Quarren42/SPIN/KiCad_Design_Files/Spin v1.4 top board/TestProject.png

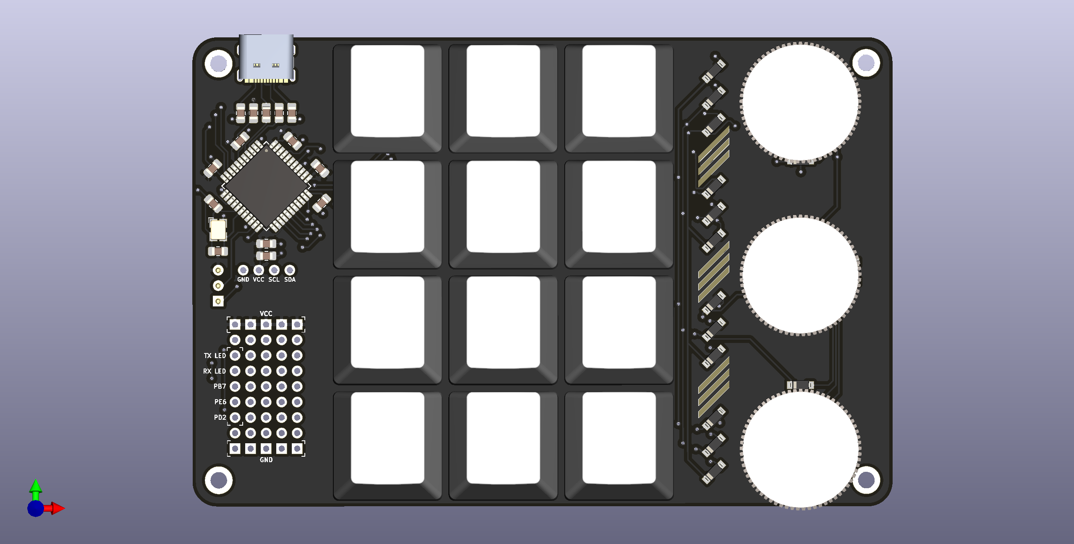
KiCad_Design_Files/Spin v1.4 top board/TestProject.png
