Quarren42/SPIN/README.md

# SPIN

SPIN

An open source 12 key, 3 encoder, hotswappable USB-C Macro Pad powered by [QMK Firmware](https://github.com/qmk/qmk_firmware)

You can purchase one at [DMQ Design](http://dmqdesign.com/), or follow the files here and build your own from scratch!
