Quarren42/SPIN/BOM/MacroPad_BOM_Assembly.xlsx

Ref. Designator | Manufacturer Part Number | Qty | Description | Package
J1 | USB4105-GF-A | 1 | USB-C USB 2.0 Receptacle Connector 24 (16 + 8 dummy) position SMD
C3, C4, C5, C6 | CL21B104KACNNNC | 4 | Ceramic Cap, 0805, 0.1uF | 0805
R3, R4 | RC0805JR-0722RL | 2 | Resistor, 0805, 22Ω | 0805
R1, R2 | RNCP0805FTD10K0 | 2 | Resistor, 0805, 10kΩ | 0805
C1, C2 | C0805C220J5GACTU | 2 | Ceramic Cap, 0805, 22pF | 0805
X1 | FA-238 16.0000MB-K3 | 1 | CRYSTAL 16.00 MHZ 10PF SMD | 4-SMD, No Lead
U1 | ATMEGA32U4-AU | 1 | IC MCU 8BIT 32KB FLASH 44TQFP | 44-TQFP
SW1 | EVQ-P7C01P | 1 | SWITCH TACTILE SPST-NO 0.05A 12V
D1, D2, D3, D4, D5, D6, D7, D8, D9, D10, D11, D12, D13, D14, D15 | 1N4148W-HE3-08 | 15 | DIODE GEN PURP 75V 150MA SOD123 | SOD123
C7 | CL21F475ZPFNNNE | 1 | Ceramic Cap, 0805, 4.7uF | 0805
C8 | CC0805ZRY5V8BB105 | 1 | Ceramic cap, 0805, 1uF | 0805
R5, R6 | CRG0805F1K5 | 2 | Resistor, 0805, 1.5kΩ | 0805
D101, D102, D103 | WS2812B | 3 | WS2812B RGB LED | PLCC4
R101 | CRGCQ0805F330R | 1 | Resistor, 0805, 330Ω | 0805
