Quarren42/SPIN/Production Files/Spin_v1.4_newReset/MacroPad_BOM_Assembly_NEW_JLC.xlsx

Comment | Designator | Footprint | JLCPCB Part #
USB-C USB 2.0 Receptacle Connector 24 (16 + 8 dummy) position SMD | J1 |  | C720629
Ceramic Cap, 0805, 0.1uF | C3, C4, C5, C6 | 0805 | C49678
Resistor, 0805, 22Ω | R3, R4 | 0805 | C17561
Resistor, 0805, 10kΩ | R1, R2 | 0805 | C17414
Ceramic Cap, 0805, 22pF | C1, C2 | 0805 | C1804
FA-328 16.0MB-K3 CRYSTAL 16.00 MHZ 10PF SMD | X1 | 4-SMD, No Lead
ATMEGA32U4-AU | U1 | 44-TQFP
DIODE GEN PURP 75V 150MA SOD123 | D1, D2, D3, D4, D5, D6, D7, D8, D9, D10, D11, D12, D13, D14, D15 | SOD123 | C169542
Ceramic Cap, 0805, 4.7uF | C7 | 0805 | C1779
Ceramic cap, 0805, 1uF | C8 | 0805 | C28323
Resistor, 0805, 5.1kΩ | R5, R6 | 0805 | C27834
WS2812B RGB LED | D101, D102, D103 | PLCC4 | C2761795
Resistor, 0805, 330Ω | R101 | 0805 | C17630
