Quarren42/SPIN/CAD_Files/AcrylicCover.dxf

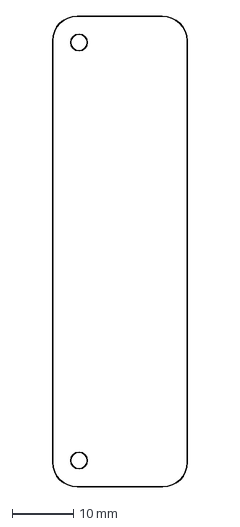
[picture p3: CAD file, 2020-04-21]
CAD_Files/AcrylicCover.dxf
22.0 x 77.0 mm
