Quarren42/SPIN/KiCad_Design_Files/Spin v1.4 bottom board/TestProject.step

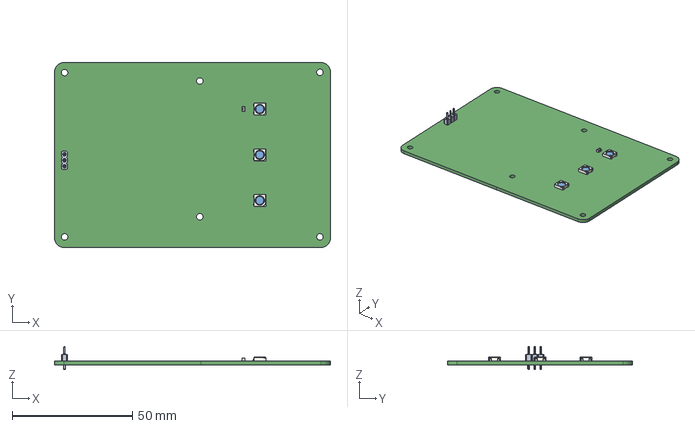
[picture p4: CAD file, 2020-04-21]
KiCad_Design_Files/Spin v1.4 bottom board/TestProject.step
114.9 x 77.0 x 9.78 mm
