Quarren42/SPIN/KiCad_Design_Files/Spin v1.4 top board/TestProject.kicad_pcb

## KiCad design KiCad_Design_Files/Spin v1.4 top board/TestProject.kicad_pcb (2020-04-21)

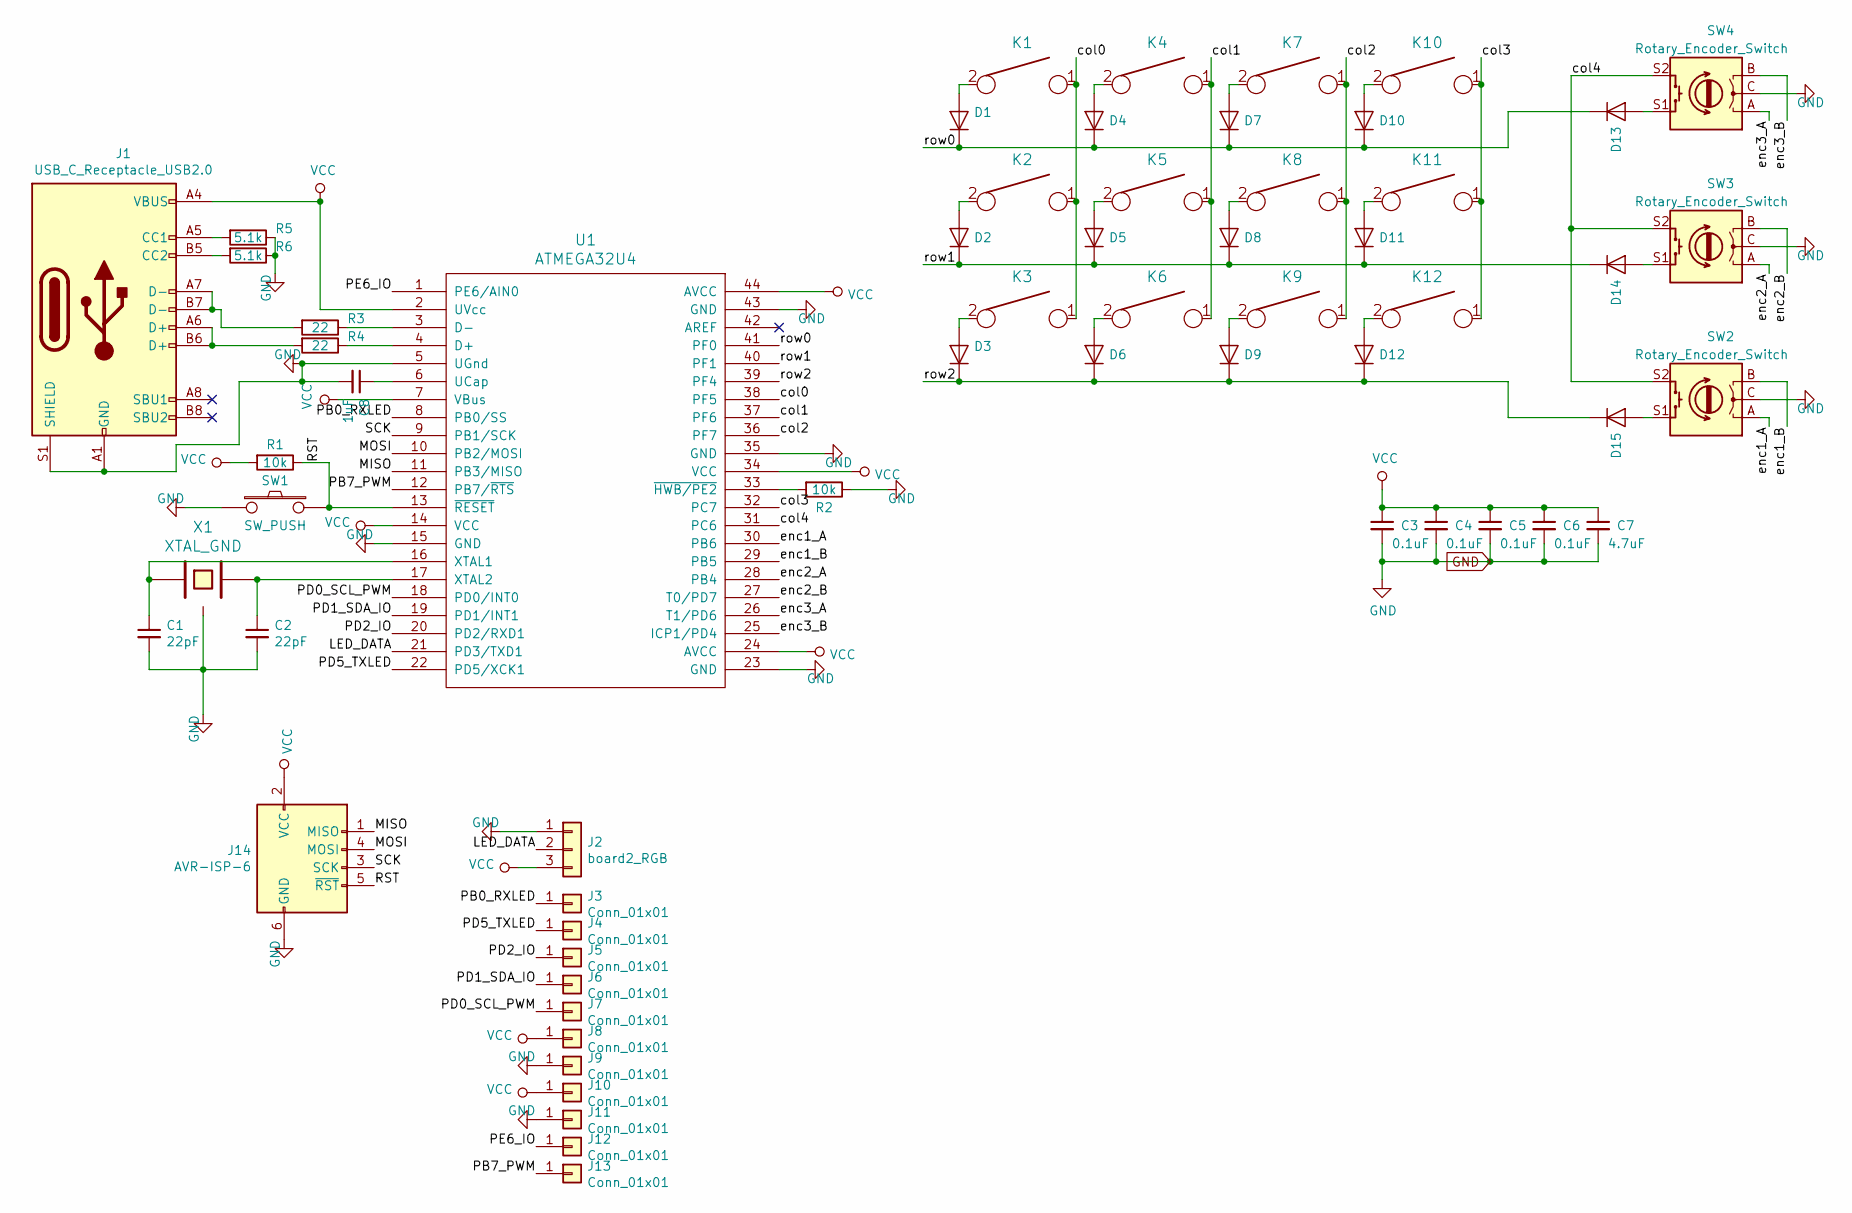
[picture p5: schematic TestProject.sch]

Parts:
C1, C2: 22pF; C_0805_2012Metric_Pad1.15x1.40mm_HandSolder
C3, C4, C5, C6: 0.1uF; C_0805_2012Metric_Pad1.15x1.40mm_HandSolder
C7: 4.7uF; C_0805_2012Metric_Pad1.15x1.40mm_HandSolder
C8: 1uF; C_0805_2012Metric_Pad1.15x1.40mm_HandSolder
D1, D2, D3, D4, D5, D6, D7, D8, D9, D10, D11, D12, D13, D14, D15: D; D_SOD123_hand
J1: USB_C_Receptacle_USB2.0; USB_C_Receptacle_Palconn_UTC16-G
J2: board2_RGB; PinHeader_1x03_P2.54mm_Vertical
J3, J4, J5, J6, J7, J8, J9, J10, J11, J12, J13: Conn_01x01; PinSocket_1x01_P2.54mm_Vertical_modified
J14: AVR-ISP-6; PinHeader_2x03_P2.54mm_Vertical_SMD
K1, K2, K3, K4, K5, K6, K7, K8, K9, K10, K11, K12: KEYSW; Kailh_socket_optional
R1, R2: 10k; C_0805_2012Metric_Pad1.15x1.40mm_HandSolder
R3, R4: 22; C_0805_2012Metric_Pad1.15x1.40mm_HandSolder
R5, R6: 5.1k; C_0805_2012Metric_Pad1.15x1.40mm_HandSolder
SW1: SW_PUSH; SW_SPST_EVQP7C
SW2, SW3, SW4: Rotary_Encoder_Switch; RotaryEncoder_Bourns_PEC12R_Horizontal_12mm
U1: ATMEGA32U4; TQFP-44_10x10mm_P0.8mm
X1: XTAL_GND; Crystal_SMD_SeikoEpson_FA238-4Pin_3.2x2.5_mm_fixed

Connections:
/LED_DATA: J2.2, U1.21 (PD3/TXD1)
/MISO: J14.1 (MISO), U1.11 (PB3/MISO)
/MOSI: J14.4 (MOSI), U1.10 (PB2/MOSI)
/PB0_RXLED: J3.1, U1.8 (PB0/SS)
/PB7_PWM: J13.1, U1.12 (PB7/~RTS)
/PD0_SCL_PWM: J7.1, U1.18 (PD0/INT0)
/PD1_SDA_IO: J6.1, U1.19 (PD1/INT1)
/PD2_IO: J5.1, U1.20 (PD2/RXD1)
/PD5_TXLED: J4.1, U1.22 (PD5/XCK1)
/PE6_IO: J12.1, U1.1 (PE6/AIN0)
/RST: J14.5 (~RST), R1.1, SW1.2, U1.13 (~RESET)
/SCK: J14.3 (SCK), U1.9 (PB1/SCK)
/col0: K1.1, K2.1, K3.1, U1.38 (PF5)
/col1: K4.1, K5.1, K6.1, U1.37 (PF6)
/col2: K7.1, K8.1, K9.1, U1.36 (PF7)
/col3: K10.1, K11.1, K12.1, U1.32 (PC7)
/col4: SW2.S2, SW3.S2, SW4.S2, U1.31 (PC6)
/enc1_A: SW2.A, U1.30 (PB6)
/enc1_B: SW2.B, U1.29 (PB5)
/enc2_A: SW3.A, U1.28 (PB4)
/enc2_B: SW3.B, U1.27 (T0/PD7)
/enc3_A: SW4.A, U1.26 (T1/PD6)
/enc3_B: SW4.B, U1.25 (ICP1/PD4)
/row0: D1.1 (K), D4.1 (K), D7.1 (K), D10.1 (K), D13.1 (K), U1.41 (PF0)
/row1: D2.1 (K), D5.1 (K), D8.1 (K), D11.1 (K), D14.1 (K), U1.40 (PF1)
/row2: D3.1 (K), D6.1 (K), D9.1 (K), D12.1 (K), D15.1 (K), U1.39 (PF4)
GND: C1.2, C2.2, C3.2, C4.2, C5.2, C6.2, C7.2, C8.2, J1.A1 (GND), J1.A12 (GND), J1.B1 (GND), J1.B12 (GND), J1.S1 (SHIELD), J2.1, J9.1, J11.1, J14.6 (GND), R2.1, R5.1, R6.1, SW1.1, SW2.C, SW3.C, SW4.C, U1.5 (UGnd), U1.15 (GND), U1.23 (GND), U1.35 (GND), U1.43 (GND), X1.3; also elsewhere on the board
unnamed: C1.1, U1.16 (XTAL1), X1.1
unnamed: C2.1, U1.17 (XTAL2), X1.2
unnamed: C8.1, U1.6 (UCap)
unnamed: D1.2 (A), K1.2
unnamed: D2.2 (A), K2.2
unnamed: D3.2 (A), K3.2
unnamed: D4.2 (A), K4.2
unnamed: D5.2 (A), K5.2
unnamed: D6.2 (A), K6.2
unnamed: D7.2 (A), K7.2
unnamed: D8.2 (A), K8.2
unnamed: D9.2 (A), K9.2
unnamed: D10.2 (A), K10.2
unnamed: D11.2 (A), K11.2
unnamed: D12.2 (A), K12.2
unnamed: D13.2 (A), SW4.S1
unnamed: D14.2 (A), SW3.S1
unnamed: D15.2 (A), SW2.S1
unnamed: J1.A5 (CC1), R5.2
unnamed: J1.A6 (D+), J1.B6 (D+), R4.2
unnamed: J1.A7 (D-), J1.B7 (D-), R3.2
unnamed: J1.B5 (CC2), R6.2
unnamed: R2.2, U1.33 (~HWB/PE2)
unnamed: R3.1, U1.3 (D-)
unnamed: R4.1, U1.4 (D+)
VCC: C3.1, C4.1, C5.1, C6.1, C7.1, J1.A4 (VBUS), J1.A9 (VBUS), J1.B4 (VBUS), J1.B9 (VBUS), J2.3, J8.1, J10.1, J14.2 (VCC), R1.2, U1.2 (UVcc), U1.7 (VBus), U1.14 (VCC), U1.24 (AVCC), U1.34 (VCC), U1.44 (AVCC); also elsewhere on the board

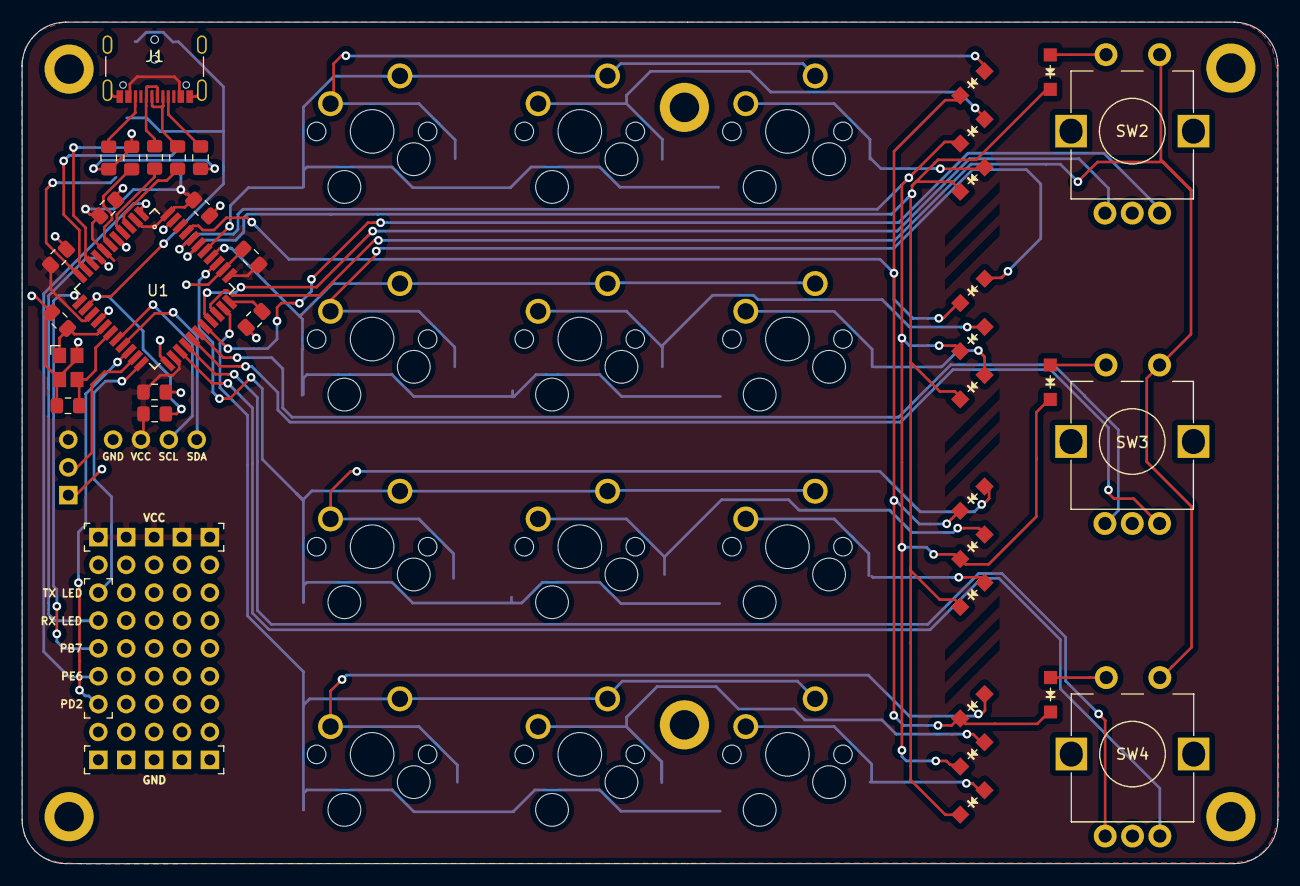
[picture p6: board KiCad_Design_Files/Spin v1.4 top board/TestProject.kicad_pcb from above]

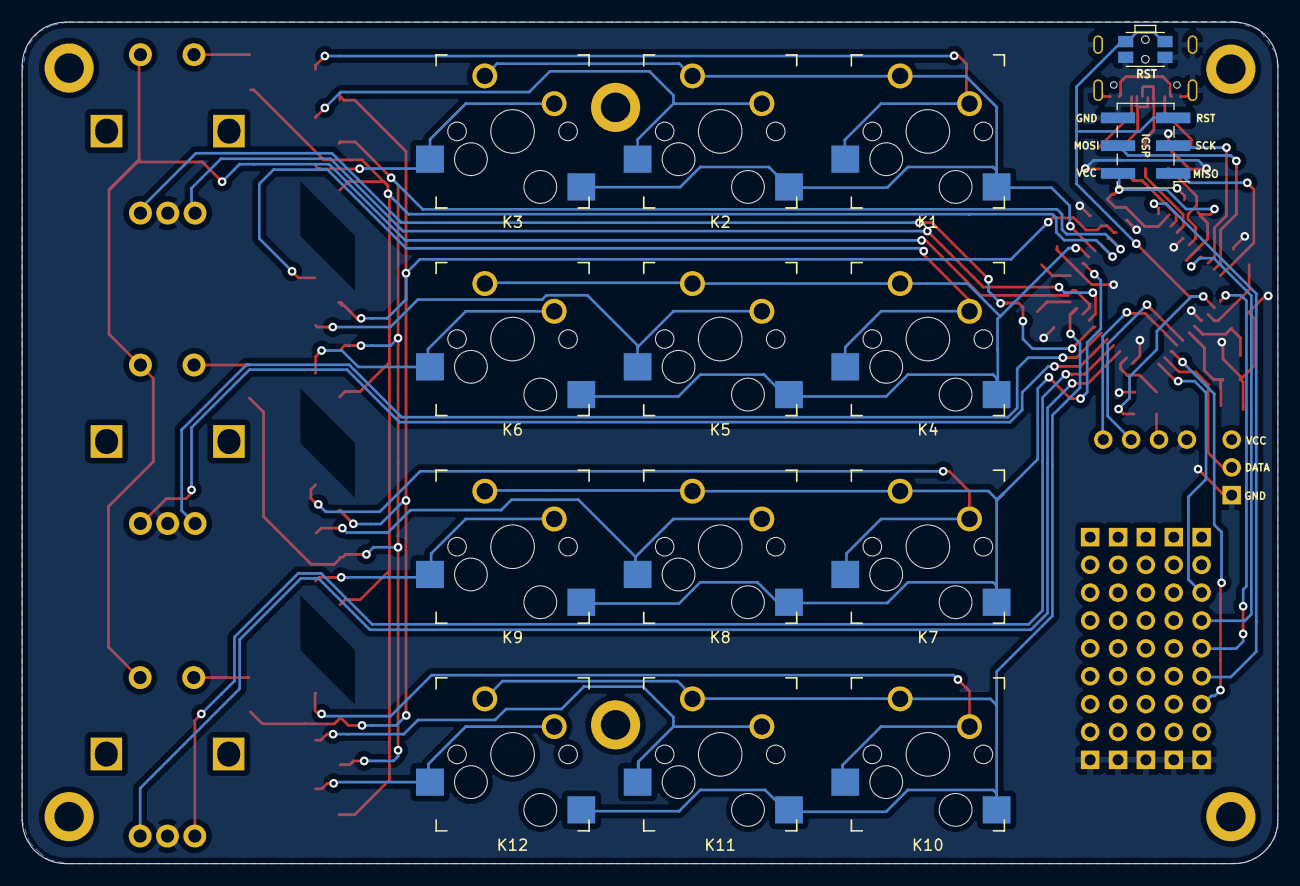
[picture p7: board KiCad_Design_Files/Spin v1.4 top board/TestProject.kicad_pcb from below]

Board: 2 copper layers, 114.9 x 77.0 mm, 69 parts (2 on the bottom side), 53 nets.

Other parts of the board:
J10#2, J10#3, J10#4, J10#5, J11#2, J11#3, J11#4, J11#5: Conn_01x01; PinSocket_1x01_P2.54mm_Vertical_modified

Their connections:
GND: J11#2.1, J11#3.1, J11#4.1, J11#5.1; also elsewhere on the board
VCC: J10#2.1, J10#3.1, J10#4.1, J10#5.1; also elsewhere on the board
