Quarren42/SPIN/KiCad_Design_Files/Spin v1.4 bottom board/TestProject.kicad_pcb

## KiCad design KiCad_Design_Files/Spin v1.4 bottom board/TestProject.kicad_pcb (2020-04-21)

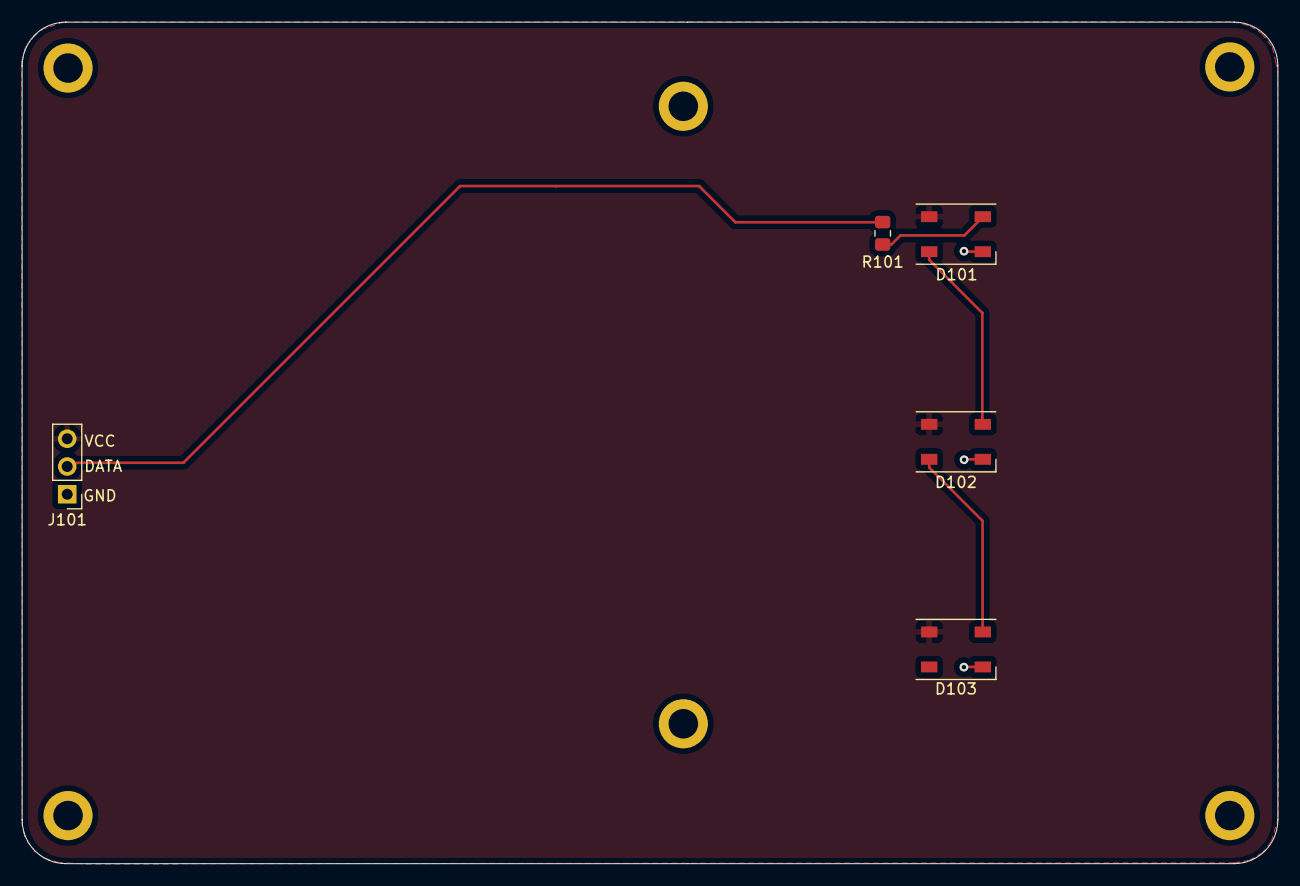
[picture p8: board KiCad_Design_Files/Spin v1.4 bottom board/TestProject.kicad_pcb from above]

Board: 2 copper layers, 114.9 x 77.0 mm, 5 parts (0 on the bottom side), 6 nets.

Parts:
D101, D102, D103: WS2812B; LED_WS2812B_PLCC4_5.0x5.0mm_P3.2mm
J101: board2_RGB; PinHeader_1x03_P2.54mm_Vertical
R101: 330; C_0805_2012Metric_Pad1.15x1.40mm_HandSolder

Connections:
/LED_DATA: J101.2, R101.2
GND: D101.3, D102.3, D103.3, J101.1
unnamed: D101.2, D102.4
unnamed: D101.4, R101.1
unnamed: D102.2, D103.4
VCC: D101.1, D102.1, D103.1, J101.3
