Quarren42/SPIN/(commit log)

2020-04-15 Added Gerbers for top/btm
    Added zipped gerber files for top and bottom board. Need to double check licenses for the part libs I used before sharing.
2020-04-21 added 3D CAD, KiCad Files, KiCad Libraries, and BOM
    [AcrylicCover.dxf, MacroPad_BOM_Assembly.xlsx, TestProject.csv, TestProject.kicad_pcb, TestProject.sch, TestProject.step]
2021-03-03 Added interactive BOM
    Added interactive BOM html file, should give some clarification on component placement compared to digging through the gerbers.
2024-07-30 Added production files from SPIN production run
    Added production files from SPIN production run - full BOM for JLCPCB assembly with JLCPCB part numbers, centroid/pos file, and top/bottom board panelized with mousebites.
    [MacroPad_BOM_Assembly_NEW_JLC.xlsx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]
